wele0612/PSP_supercapacitor/supercapv4.ioc

Mcu.UserName=STM32G474RBTx
PA10.Signal=HRTIM1_CHB1
PA11.Signal=HRTIM1_CHB2
PA13.Signal=SYS_JTMS-SWDIO
PA14.Signal=SYS_JTCK-SWCLK
PA15.GPIO_Label=EN_11V7
PA15.Signal=GPIO_Output
PA2.Signal=ADC1_IN3
PA3.Signal=ADC1_IN4
PA5.Signal=ADC2_IN13
PA8.Signal=HRTIM1_CHA1
PA9.Signal=HRTIM1_CHA2
PB0.Signal=ADC3_IN12
PB1.Signal=ADC3_IN1
PB11.GPIO_Label=DRV_EN
PB11.Signal=GPIO_Output
PB2.Signal=ADC2_IN12
PB3.Signal=SPI3_SCK
PB4.Signal=SPI3_MISO
PB5.Signal=FDCAN2_RX
PB6.Signal=FDCAN2_TX
PC10.Signal=UART4_TX
PC11.Signal=UART4_RX
PC12.Signal=SPI3_MOSI
PC13.Signal=GPIO_Output
PC4.Signal=ADC2_IN5
PC6.Signal=HRTIM1_CHF1
PC7.Signal=HRTIM1_CHF2
PC8.Signal=HRTIM1_CHE1
PC9.Signal=HRTIM1_CHE2
PF0-OSC_IN.Signal=RCC_OSC_IN
PF1-OSC_OUT.Signal=RCC_OSC_OUT
