wele0612/PSP_supercapacitor/Core/Inc/main.h

#define DRV_EN_Pin GPIO_PIN_11
#define DRV_EN_GPIO_Port GPIOB
#define EN_11V7_Pin GPIO_PIN_15
#define EN_11V7_GPIO_Port GPIOA
